cristiannnnnnnn/motorboot/readme/boat.png

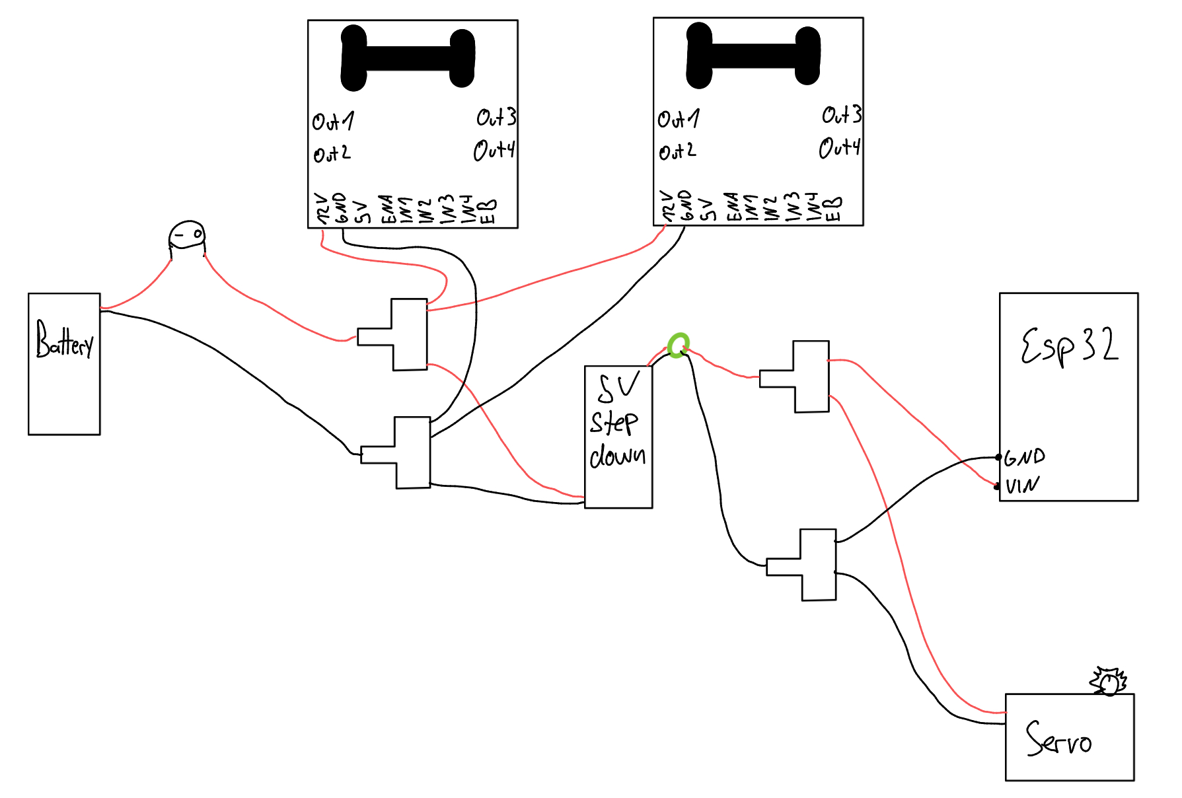
readme/boat.png
