cristiannnnnnnn/motorboot/readme/controller.png

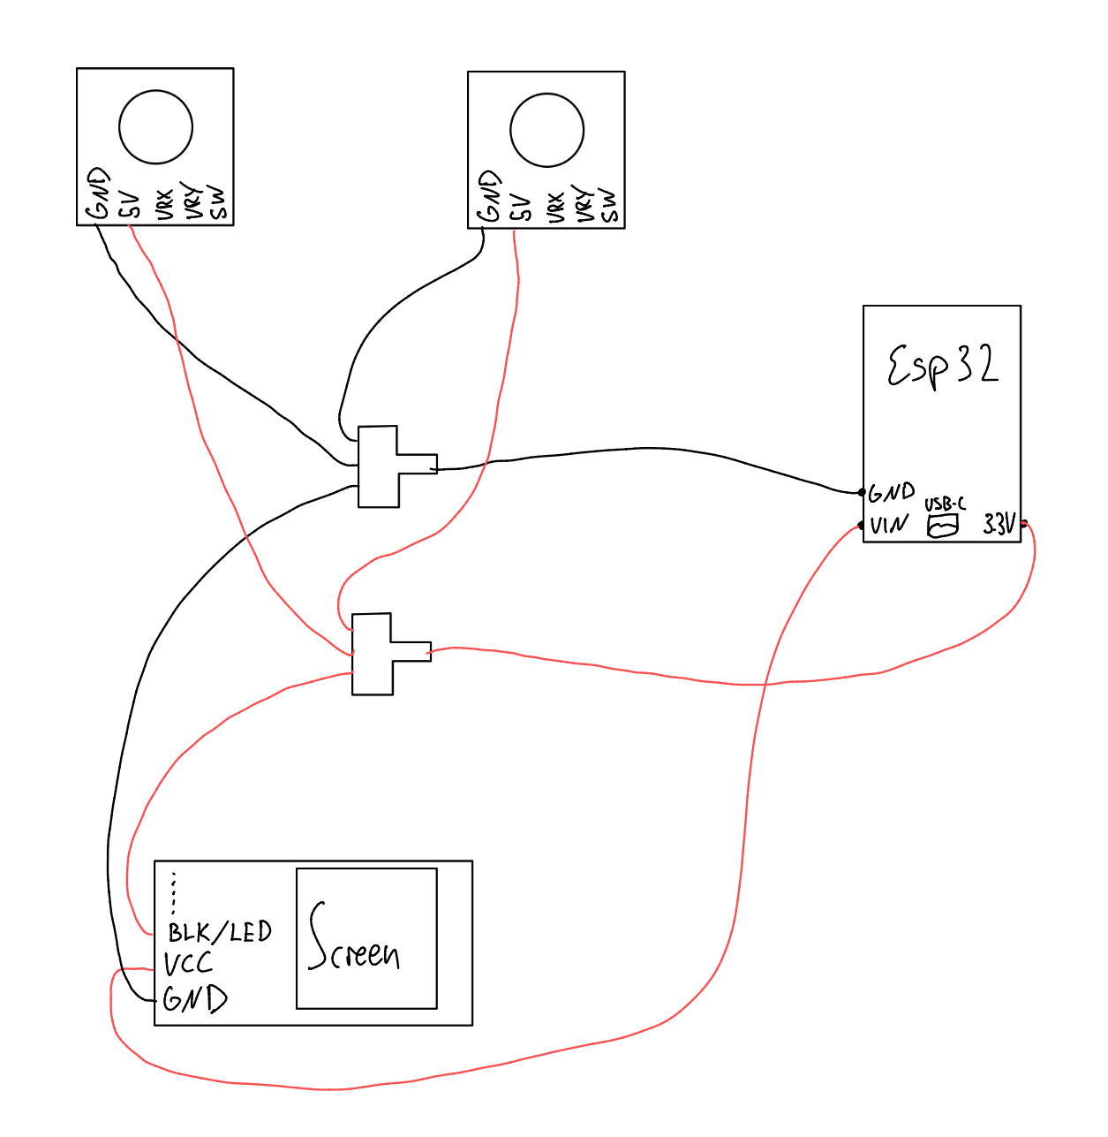
readme/controller.png
