cristiannnnnnnn/motorboot/readme/rudderstep5.jpg

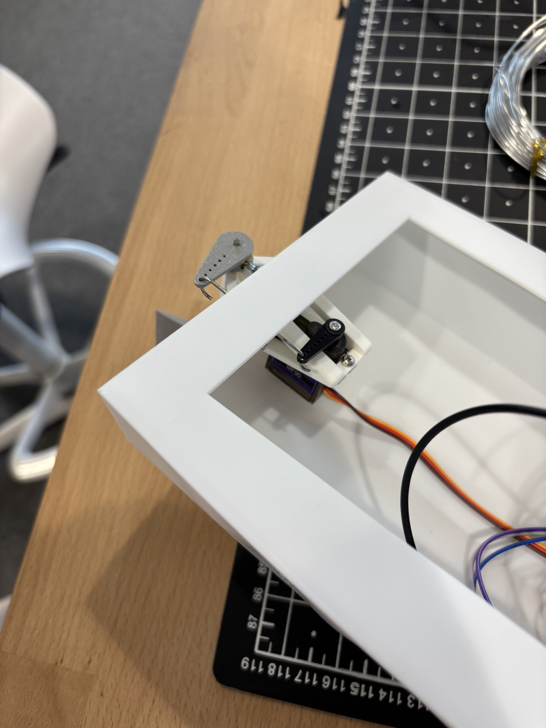
[picture p8: readme/rudderstep5.jpg]
readme/rudderstep5.jpg
