cristiannnnnnnn/motorboot/readme/rudderstep51.jpg

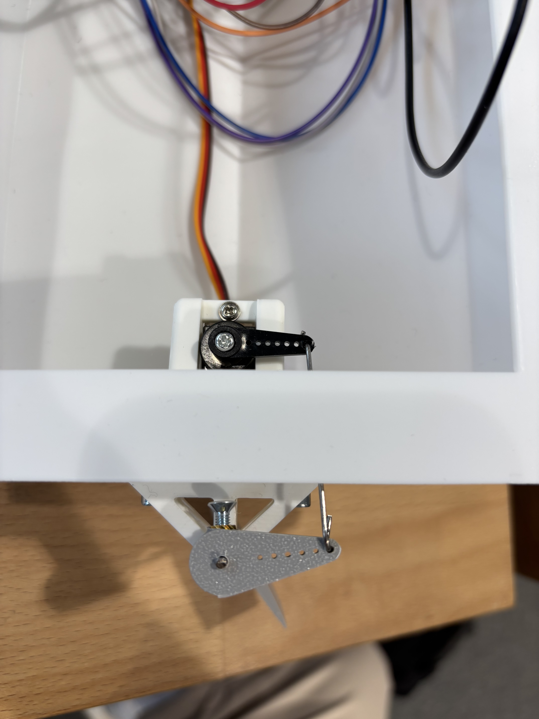
[picture p9: readme/rudderstep51.jpg]
readme/rudderstep51.jpg
