cristiannnnnnnn/motorboot/readme/rudderstep52.jpg

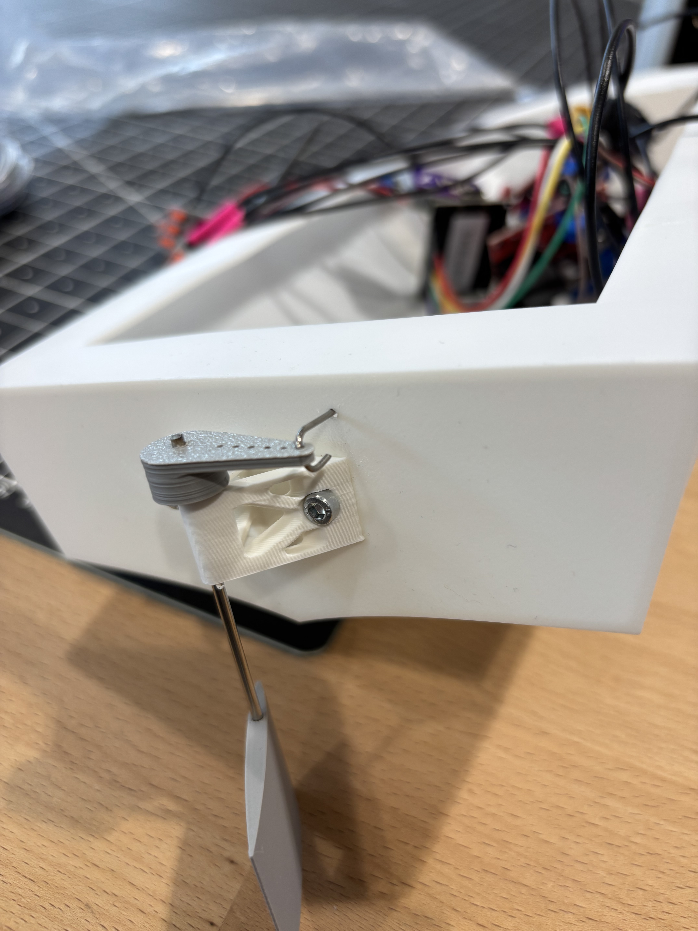
[picture p10: readme/rudderstep52.jpg]
readme/rudderstep52.jpg
