cristiannnnnnnn/motorboot/readme/peakengineering.jpg

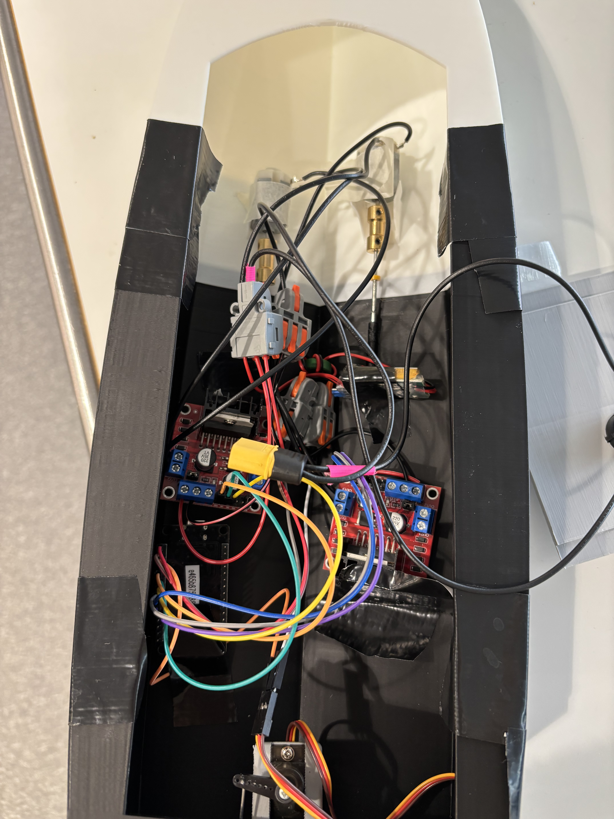
[picture p13: readme/peakengineering.jpg]
readme/peakengineering.jpg
